adnanzami/Outdoor-Autonomous-Mobile-Robot-/img/PIRsensor.jpg

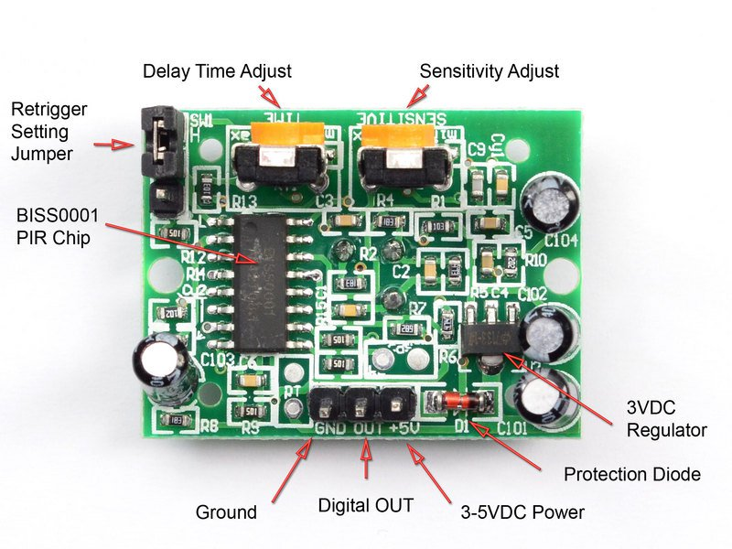
img/PIRsensor.jpg
