adnanzami/Outdoor-Autonomous-Mobile-Robot-/img/motion-detector-circuit.png

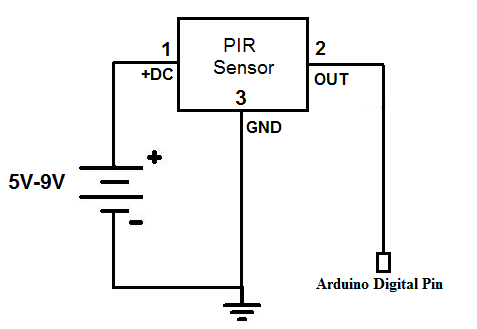
img/motion-detector-circuit.png
